disarmyouwitha/Boardsource-StenoSquid/ATTRIBUTION.md

# Attribution

Steno Squid is an independent community accessory for the Boardsource Wireless Corne SMT. The daughterboard layout and custom circuit symbols were created for this project.

## Design references

- **Boardsource** supplied the host expansion pinout and firmware configuration used to check the interface. [Wireless SMT Corne documentation](https://boardsource.xyz/blogs/guides/wireless-smt-corne-docs) · [Boardsource ZMK configuration](https://github.com/boardsource/wireless-corne_zmk_config)
- **Winbond** supplied the W25Q128JV electrical specifications and package drawing used to create the custom WSON footprint. [Winbond datasheet](https://mm.digikey.com/Volume0/opasdata/d220001/medias/docus/7159/W25Q128JV.pdf)

## Artwork and project license

Pop is the Steno Squid mascot on the current PCB. The earlier Inkling fan illustration drew on Nintendo’s *Splatoon*. [Editable Pop artwork](artwork/pop-centered-gaze-silkscreen.svg) · [Earlier artwork](artwork/inkling-silkscreen.svg)

The original Steno Squid hardware design has no published redistribution license.
