disarmyouwitha/Boardsource-StenoSquid/pcb/previews/back.png

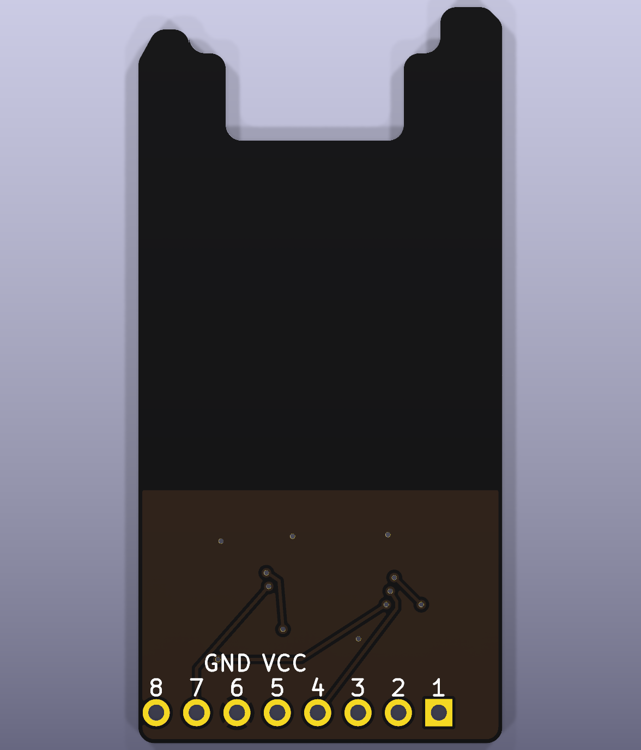
pcb/previews/back.png
