disarmyouwitha/Boardsource-StenoSquid/pcb/models/WSON-8_6x5mm_EP3.4x4.3mm.step

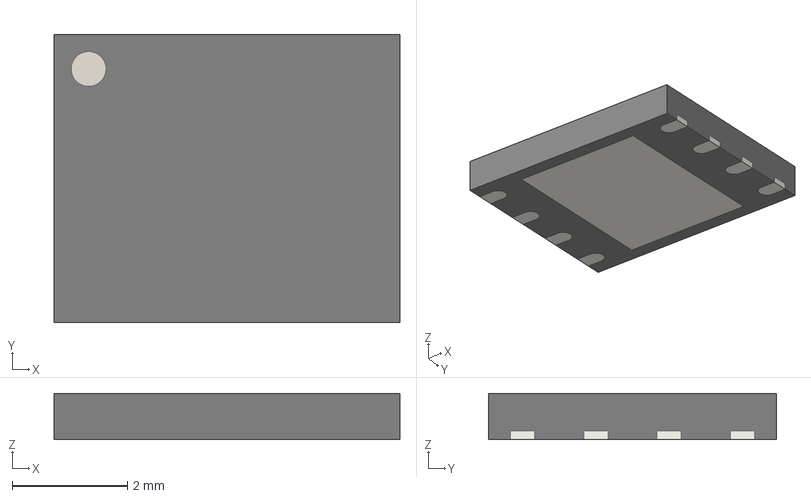
[picture p3: CAD file, 2026-11-14]
pcb/models/WSON-8_6x5mm_EP3.4x4.3mm.step
6.00 x 5.00 x 0.8 mm
