disarmyouwitha/Boardsource-StenoSquid/pcb/steno-squid.step

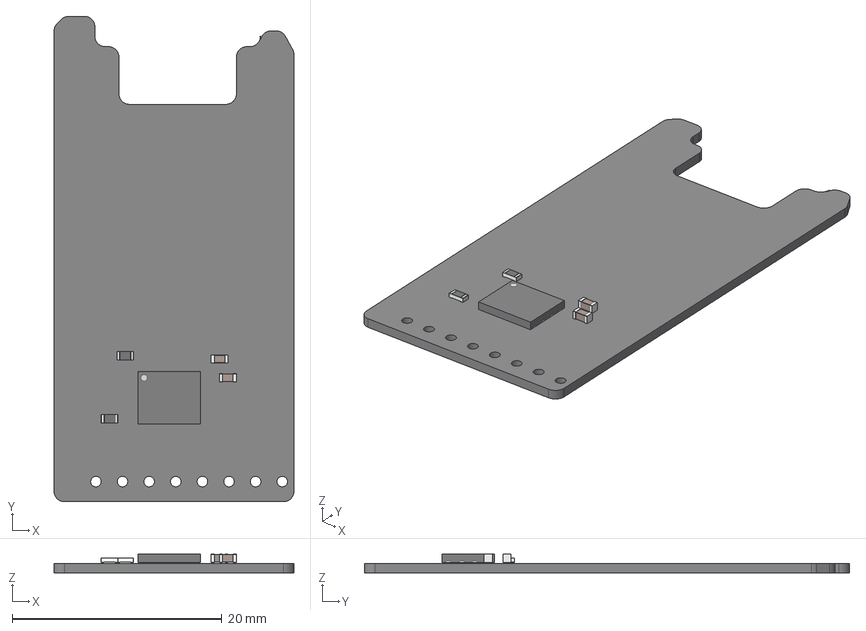
[picture p4: CAD file, 2026-11-14]
pcb/steno-squid.step
22.9 x 46.3 x 1.79 mm
WDFN-8-1EP_6x5mm_P1.27mm_EP3.4x4.3mm
C_0603_1608Metric x 2
R_0603_1608Metric x 2
steno-squid_PCB
