disarmyouwitha/Boardsource-StenoSquid/pcb/steno-squid.kicad_pcb

## KiCad design pcb/steno-squid.kicad_pcb (2026-11-14)

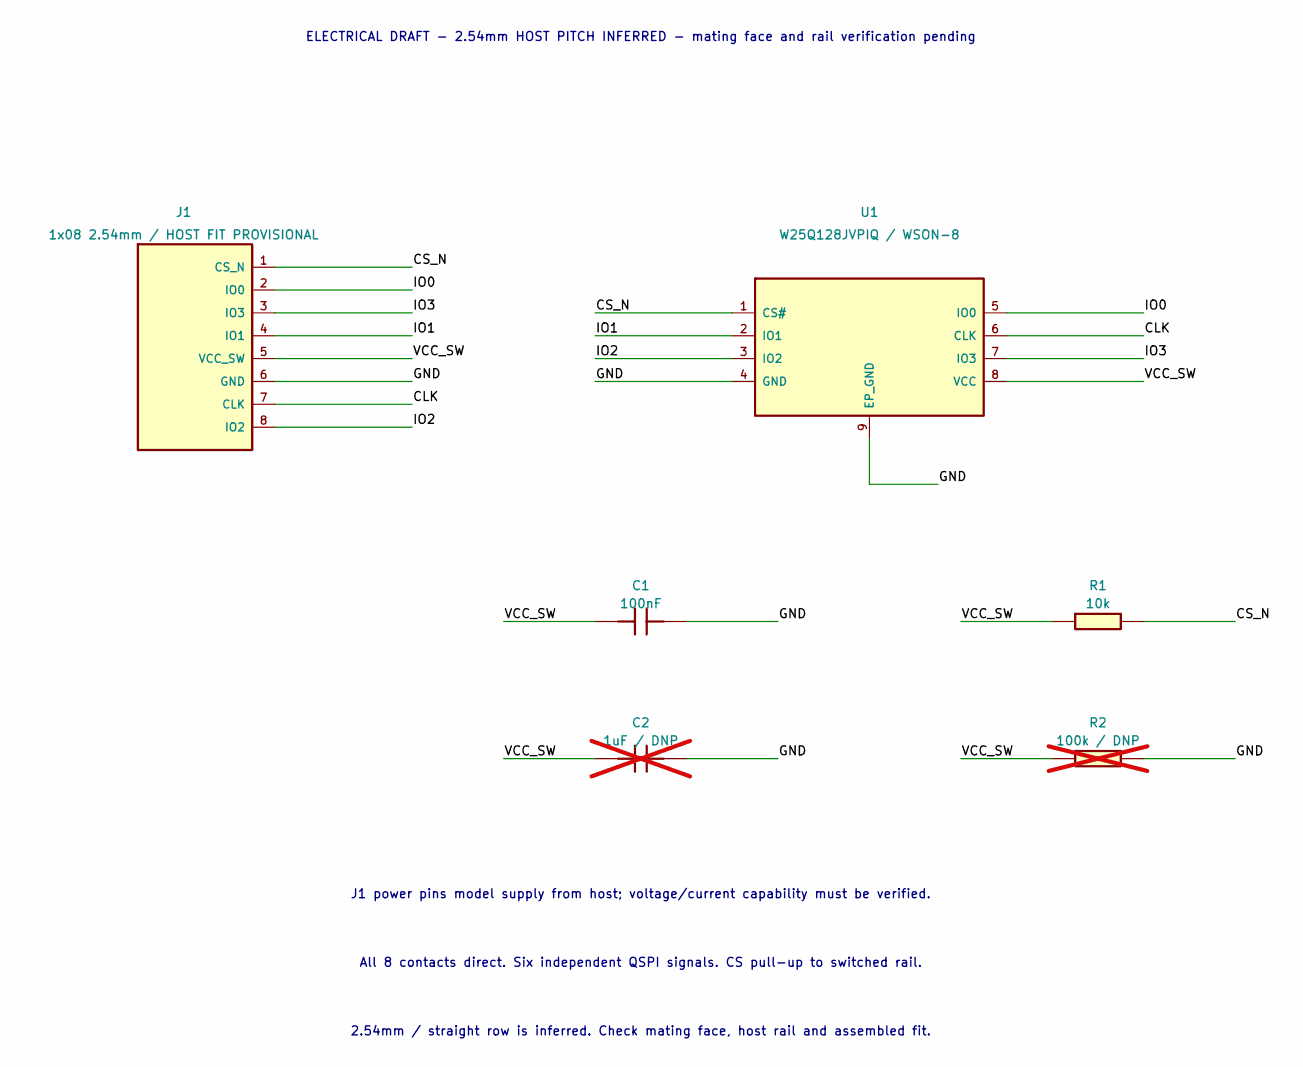
[picture p5: schematic steno-squid.kicad_sch, Steno Squid - 8-contact QSPI electrical proposal]

Parts:
C1: 100nF; C_0603_1608Metric
C2: 1uF / DNP; C_0603_1608Metric; not fitted
J1: 1x08 2.54mm / HOST FIT PROVISIONAL; PinHeader_1x08_P2.54mm_Vertical
R1: 10k; R_0603_1608Metric
R2: 100k / DNP; R_0603_1608Metric; not fitted
U1: W25Q128JVPIQ / WSON-8; WSON-8_6x5mm_P1.27mm_EP3.4x4.3mm

Connections:
/CLK: J1.7 (CLK), U1.6 (CLK)
/CS_N: J1.1 (CS_N), R1.2, U1.1 (CS#)
/GND: C1.2, C2.2, J1.6 (GND), R2.2, U1.4 (GND), U1.9 (EP_GND)
/IO0: J1.2 (IO0), U1.5 (IO0)
/IO1: J1.4 (IO1), U1.2 (IO1)
/IO2: J1.8 (IO2), U1.3 (IO2)
/IO3: J1.3 (IO3), U1.7 (IO3)
/VCC_SW: C1.1, C2.1, J1.5 (VCC_SW), R1.1, R2.1, U1.8 (VCC)

Notes on the sheet:
ELECTRICAL DRAFT - 2.54mm HOST PITCH INFERRED - mating face and rail verification pending
J1 power pins model supply from host; voltage/current capability must be verified.
All 8 contacts direct. Six independent QSPI signals. CS pull-up to switched rail.
2.54mm / straight row is inferred. Check mating face, host rail and assembled fit.

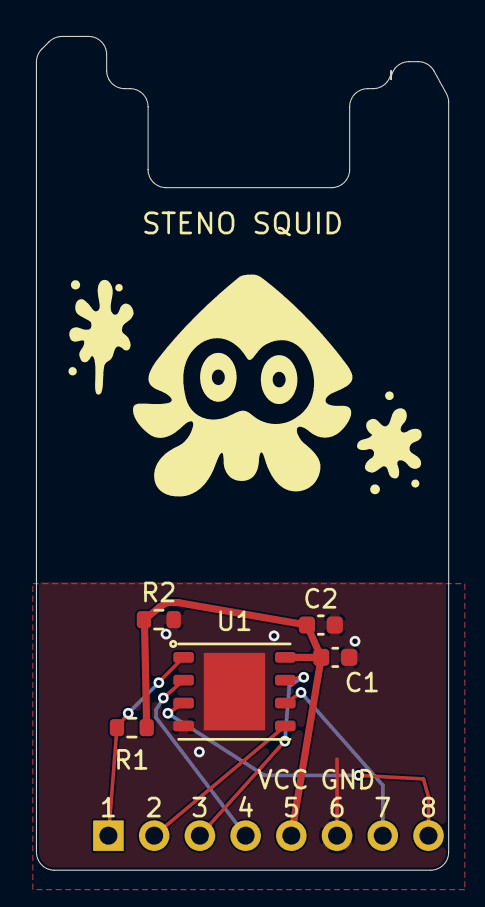
[picture p6: board steno-squid.kicad_pcb from above]

Board: 2 copper layers, 22.9 x 46.3 mm, 6 parts (0 on the bottom side), 8 nets.
