disarmyouwitha/Boardsource-StenoSquid/docs/history.md

# Design history

The [current KiCad project](../pcb/README.md) lives in one directory. Earlier layouts, review notes, artwork studies and tooling are available in Git at the snapshots below.

| Snapshot | What it contains |
|---|---|
| [Initial electrical and SOIC studies](https://github.com/disarmyouwitha/Boardsource-StenoSquid/tree/2afdddb) | Breakout proof of concept, compatibility research and the first routed daughterboard |
| [Low-profile WSON layout](https://github.com/disarmyouwitha/Boardsource-StenoSquid/tree/19645d1/draft-2) | Locked QSPI wiring, Inkling artwork and improved power and ground routing |
| [Back-mounted comparison](https://github.com/disarmyouwitha/Boardsource-StenoSquid/tree/45ae03b/draft-3) | Components below the board and rotated front artwork |
| [Plate-top layout with antenna cutback](https://github.com/disarmyouwitha/Boardsource-StenoSquid/tree/ed61a56/draft-4) | Fallback with ground pulled back near contacts 6–8, available for comparison if Bluetooth testing calls for it |
| [Last snapshot before consolidation](https://github.com/disarmyouwitha/Boardsource-StenoSquid/tree/bc5cb17) | All previous folders, alternate paper templates and [review records](https://github.com/disarmyouwitha/Boardsource-StenoSquid/tree/bc5cb17/docs) |
