disarmyouwitha/Boardsource-StenoSquid/(commit log)

2026-11-11 Publish Steno Squid routed prototype and compatibility research
    [BOM.csv, steno-squid.kicad_pcb, steno-squid.kicad_sch, steno-squid.step]
2026-11-11 Add review notes for the next draft to the README
    Notes from reading the draft-1 board file and the Boardsource firmware
    branch against the published pinout: labelling, orientation, component
    height, a bleed resistor footprint, flash part IDs and the LED.
2026-11-11 Add second-pass review notes after comparing with Codex's review
    WSON-8 package preference, Winbond lifecycle status for five W25Q128JV
    ordering codes, the clock pin decision, shared rail check, build
    evidence without CI, ignored DRC categories, artwork face and user
    guidance.
2026-11-11 Record WSON-8, pin-map test and firmware decisions in review notes
    WSON-8 is the package for the next draft, with JLCPCB stock as checked
    on 2026-11-11. The pin map will be compared on a breadboard against a
    candidate map. ZMK Studio stays enabled and the host layout should be
    controlled from ZMK.
2026-11-11 Lock the pin map and record Studio and host-layout decisions
    The module moves to the pins Nordic marks for QSPI: CLK on P0.19, IO1
    on P0.23 and IO3 on P0.12, checked against Nordic's aQFN73 pin table
    on 2026-11-11. Lists what must change together in this repository and
    the firmware. ZMK Studio stays enabled, with three issues and proposed
    fixes; the host layout stays in Javelin Steno Tools.
2026-11-12 Implement WSON Draft B and locked pin-map review changes
    [BOM.csv, steno-squid.kicad_pcb, steno-squid.kicad_sch, steno-squid.step]
2026-11-12 Add Claude's review of Draft B
    Record the confirmed items and the changes to make before ordering:
    ground vias beside U1 and C1, a wider and shorter VCC_SW track, and
    the stale firmware note in docs/review-status.md.
2026-11-12 Improve Draft B flash power and ground routing
    [steno-squid.kicad_pcb, steno-squid.step]
2026-11-12 Draw an Inkling squid for the Draft B silkscreen
    [steno-squid.kicad_pcb]
2026-11-12 Clean up spacing after the silkscreen replacement
    [steno-squid.kicad_pcb]
2026-11-12 Add back-mounted Steno Squid Draft C
    [BOM.csv, steno-squid.kicad_pcb, steno-squid.kicad_sch, steno-squid.step]
2026-11-12 Add the plate and mounting notes and the Draft D design brief
    Record what the Boardsource PCB and switch plate show: the notch is the
    battery cutout, the plate slot passes the header pins, and the squid
    lies flush on top of the plate with parts up. Add a scale drawing of
    the measured plate area and a brief for Draft D: fill the solid plate
    area, contact row at the bottom edge with pin 1 left (checked against
    the nice!view pin order), pins through the slot, R2 and C2 fitted.
    Plate sizes are estimates from an image. No board file was generated.
2026-11-12 Leave R2 and C2 unfitted until the breadboard rail test
    R2 draws about 33 uA continuously at 100 k while the rail is on. Keep
    both footprints, fit neither, and size a larger R2 (470 k to 1 M, C2 off)
    only if the Adafruit breakout test shows a slow fall.
2026-11-12 Add 1:1 Draft D paper templates and generator
    Full-ears, short-ears and full-ears-no-cutout SVG templates with connector
    hole centres and placeholder part footprints.
2026-11-12 Add suspected antenna section and copper rules to Draft D brief
2026-11-13 Implement plate-mounted Steno Squid Draft D
    [BOM.csv, steno-squid.kicad_pcb, steno-squid.kicad_sch, steno-squid.step]
2026-11-13 Document the current plate-mounted Steno Squid
2026-11-13 Restore ground around the Steno Squid QSPI contacts
    [steno-squid.kicad_pcb]
2026-11-13 Consolidate the Steno Squid PCB and archive prior drafts in Git history
    [BOM.csv, steno-squid.kicad_pcb, steno-squid.kicad_sch, steno-squid.step]
2026-11-13 Trim prototype references from attribution
2026-11-13 Point the firmware CI links at the Boardsource branch
    The links named a run from before the firmware merges. A branch-filtered
    workflow link does not go stale.
2026-11-13 Add the pre-order checklist and record the antenna and pad decisions
2026-11-14 Apply flash board electrical and assembly review fixes
    [BOM.csv, WSON-8_6x5mm_EP3.4x4.3mm.step, steno-squid.kicad_pcb, steno-squid.kicad_sch, steno-squid.step]
2026-11-14 Add Pop mascot to the front silkscreen
    [steno-squid.kicad_pcb]
2026-11-14 Show the Pop board preview in the README
2026-11-14 Rename project to StenoSquid-PCB
    Updated project name and added GitHub link.
