disarmyouwitha/Boardsource-StenoSquid/(notices)

Notices in the files:
pcb/models/WSON-8_6x5mm_EP3.4x4.3mm.step:
Copyright (C) 2026, KiCAD
This work is licensed under the
[Creative Commons CC-BY-SA 4.0 License](https://creativecommons.org/licenses/by-sa/4.0/legalcode),
with the following exception:
project files under this or any other license agreement. However, if you wish to distribute
